mouzzamqazi/JediGlove/JediGloveImages/JediGlove_Top_view.jpg

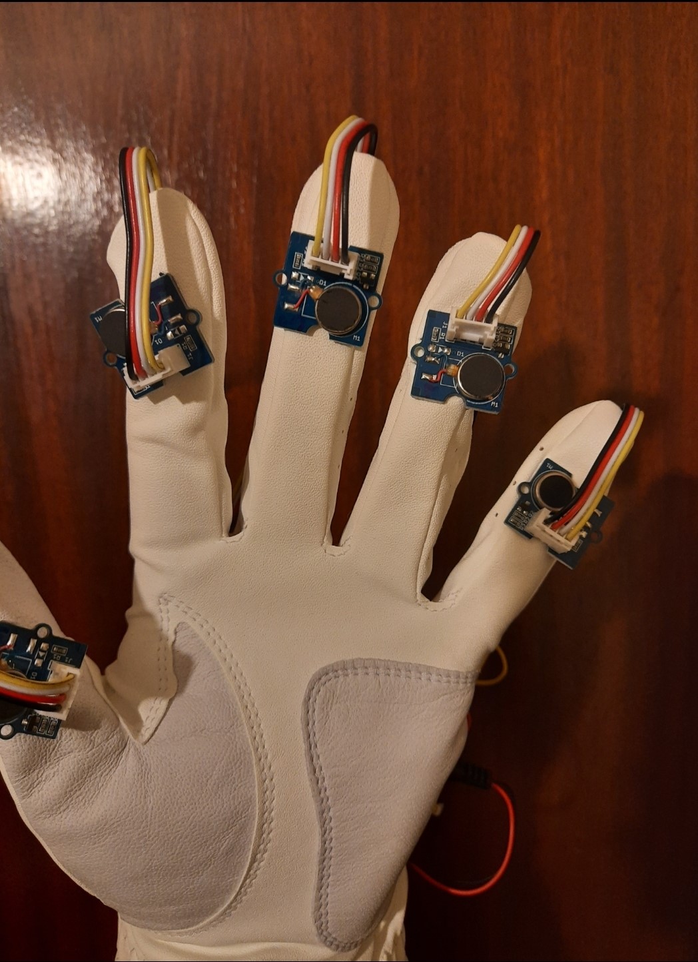
JediGloveImages/JediGlove_Top_view.jpg
