mouzzamqazi/JediGlove/JediGloveImages/JediGlove_side_view.jpg

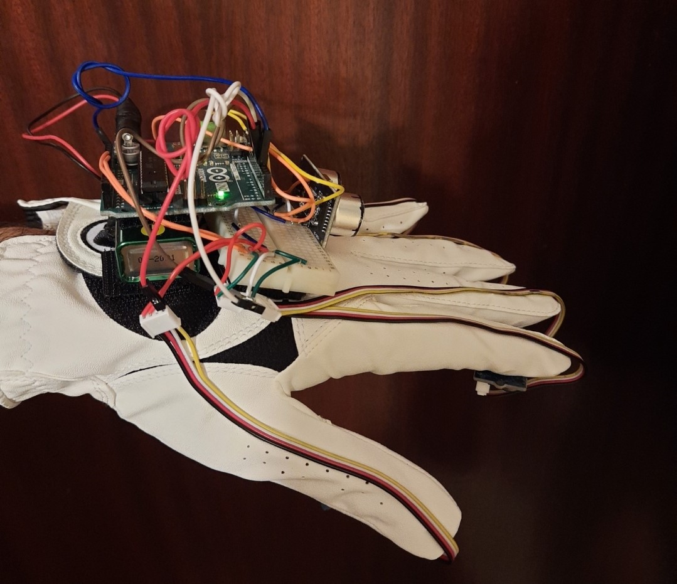
JediGloveImages/JediGlove_side_view.jpg
