mouzzamqazi/JediGlove/README.md

# JediGlove
This is an ergonomic glove prototype which can be used by blind people for navigation purpose in their lives.
The JediGlove is a perfect example of combination of electronics, software and mechanical concepts.
The three main modules used were ultrasonic module, vibration motor and the microcontroller.
Report has been uploaded for better understanding.
The images shared are of the modified JediGlove.
